mdion1/ESC_firmware/ESC schem and pcb layout - alt/ESC.kicad_pcb

## KiCad design ESC schem and pcb layout - alt/ESC.kicad_pcb (2023-04-29)

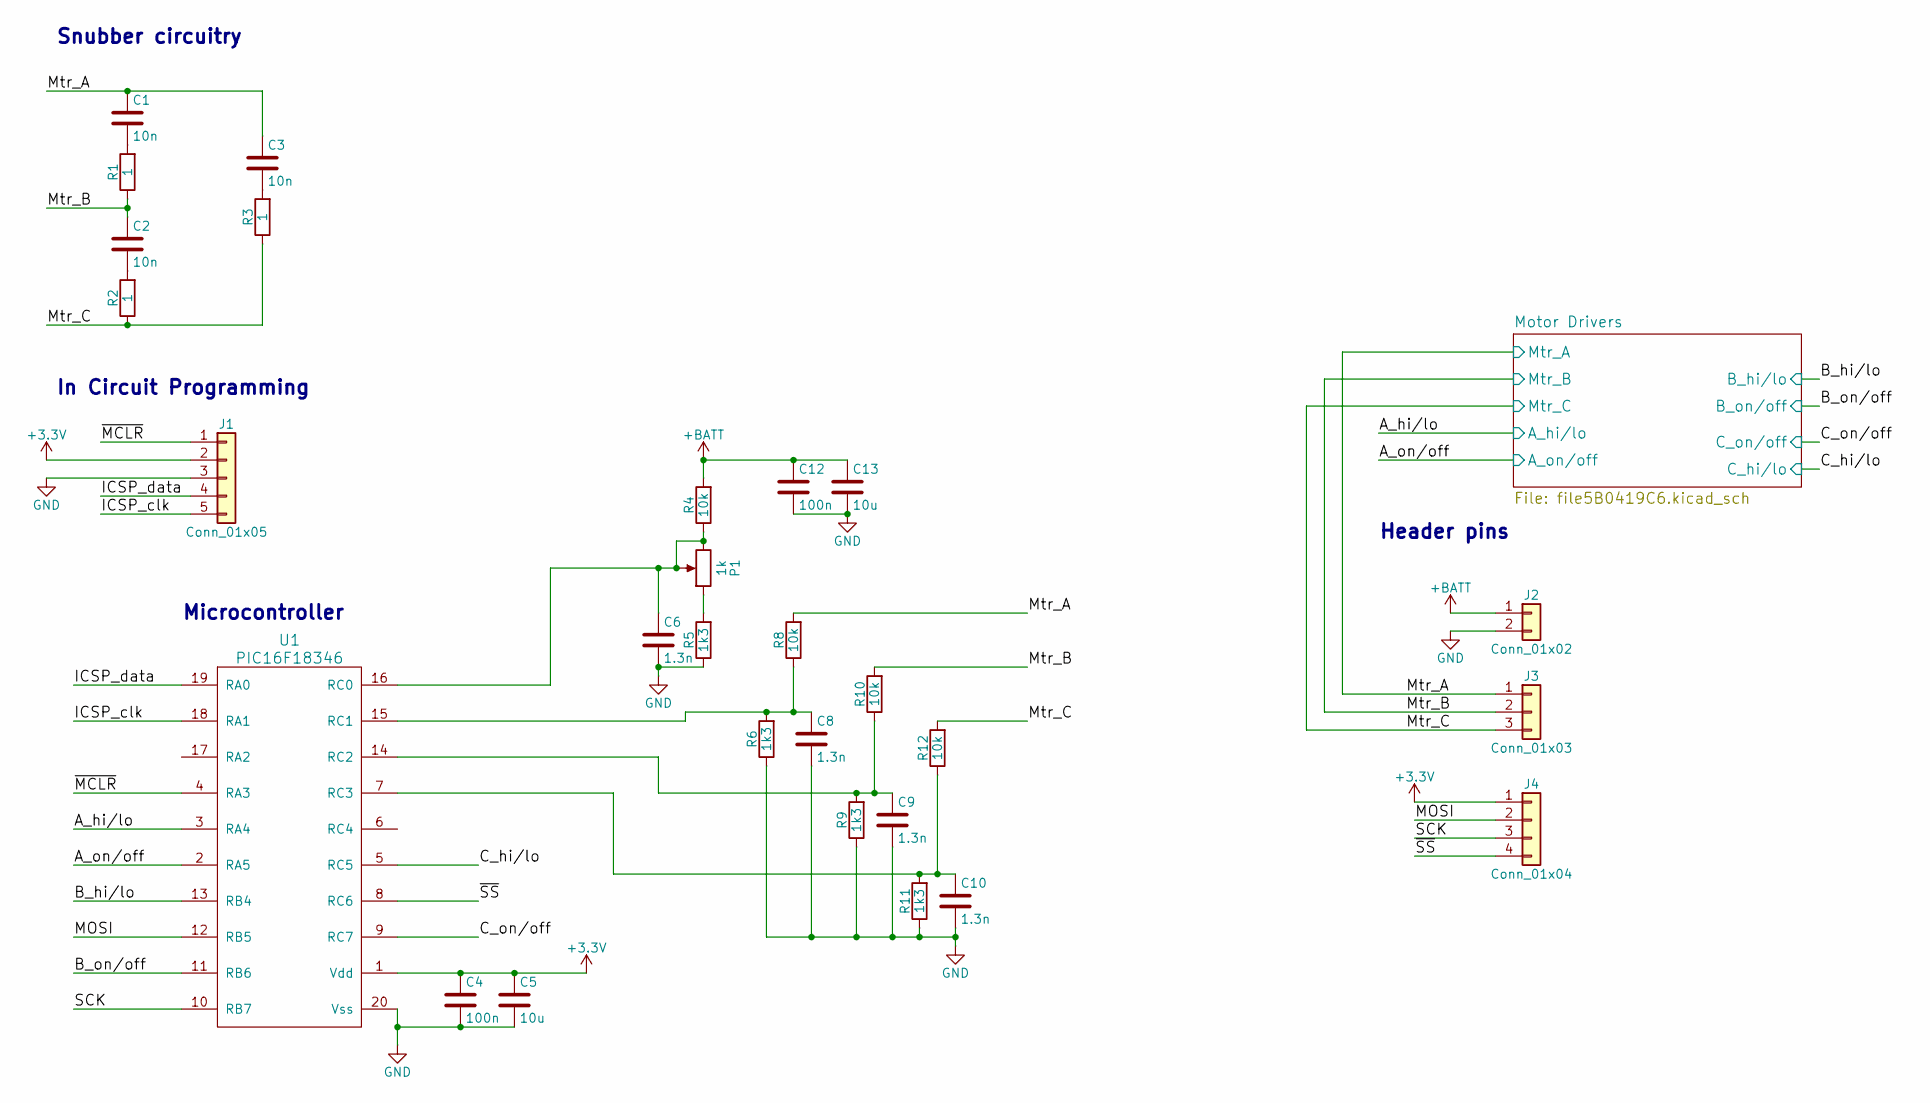
[picture p1: schematic ESC.kicad_sch]

Parts:
C1, C2, C3: 10n; C_0603_HandSoldering
C4, C12: 100n; C_0603_HandSoldering
C5, C13: 10u; C_0603_HandSoldering
C6, C8, C9, C10: 1.3n; C_0603_HandSoldering
J1: Conn_01x05; Male_header_pins_1x5
J2: Conn_01x02; Wire-to-board_1x2
J3: Conn_01x03; Wire-to-board_1x3
J4: Conn_01x04; Wire_to_board_cluster__4
P1: 1k; Potentiometer_Trimmer_Bourns_3223W
R1, R2, R3: 1; R_0603_HandSoldering
R4, R8, R10, R12: 10k; R_0603_HandSoldering
R5, R6, R9, R11: 1k3; R_0603_HandSoldering
U1: PIC16F18346; SOIC-20W_7.5x12.8mm_Pitch1.27mm

Connections:
+3V3: C4.1, C5.1, J1.2, J4.1, U1.1 (Vdd)
+BATT: C12.1, C13.1, J2.1, R4.2; also elsewhere on the board
/A_hi/lo: U1.3 (RA4); also elsewhere on the board
/A_on/off: U1.2 (RA5); also elsewhere on the board
/B_hi/lo: U1.13 (RB4); also elsewhere on the board
/B_on/off: U1.11 (RB6); also elsewhere on the board
/C_hi/lo: U1.5 (RC5); also elsewhere on the board
/C_on/off: U1.9 (RC7); also elsewhere on the board
/ICSP_clk: J1.5, U1.18 (RA1)
/ICSP_data: J1.4, U1.19 (RA0)
/MOSI: J4.2, U1.12 (RB5)
/Mtr_A: C1.1, C3.1, J3.1, R8.2; also elsewhere on the board
/Mtr_B: C2.1, J3.2, R1.1, R10.2; also elsewhere on the board
/Mtr_C: J3.3, R2.1, R3.1, R12.2; also elsewhere on the board
/SCK: J4.3, U1.10 (RB7)
/~MCLR: J1.1, U1.4 (RA3)
/~SS: J4.4, U1.8 (RC6)
GND: C4.2, C5.2, C6.2, C8.2, C9.2, C10.2, C12.2, C13.2, J1.3, J2.2, R5.1, R6.1, R9.1, R11.1, U1.20 (Vss); also elsewhere on the board
unnamed: C1.2, R1.2
unnamed: C2.2, R2.2
unnamed: C3.2, R3.2
unnamed: C6.1, P1.2, P1.3, R4.1, U1.16 (RC0)
unnamed: C8.1, R6.2, R8.1, U1.15 (RC1)
unnamed: C9.1, R9.2, R10.1, U1.14 (RC2)
unnamed: C10.1, R11.2, R12.1, U1.7 (RC3)
unnamed: P1.1, R5.2

Notes on the sheet:
In Circuit Programming
Header pins
Microcontroller
Snubber circuitry

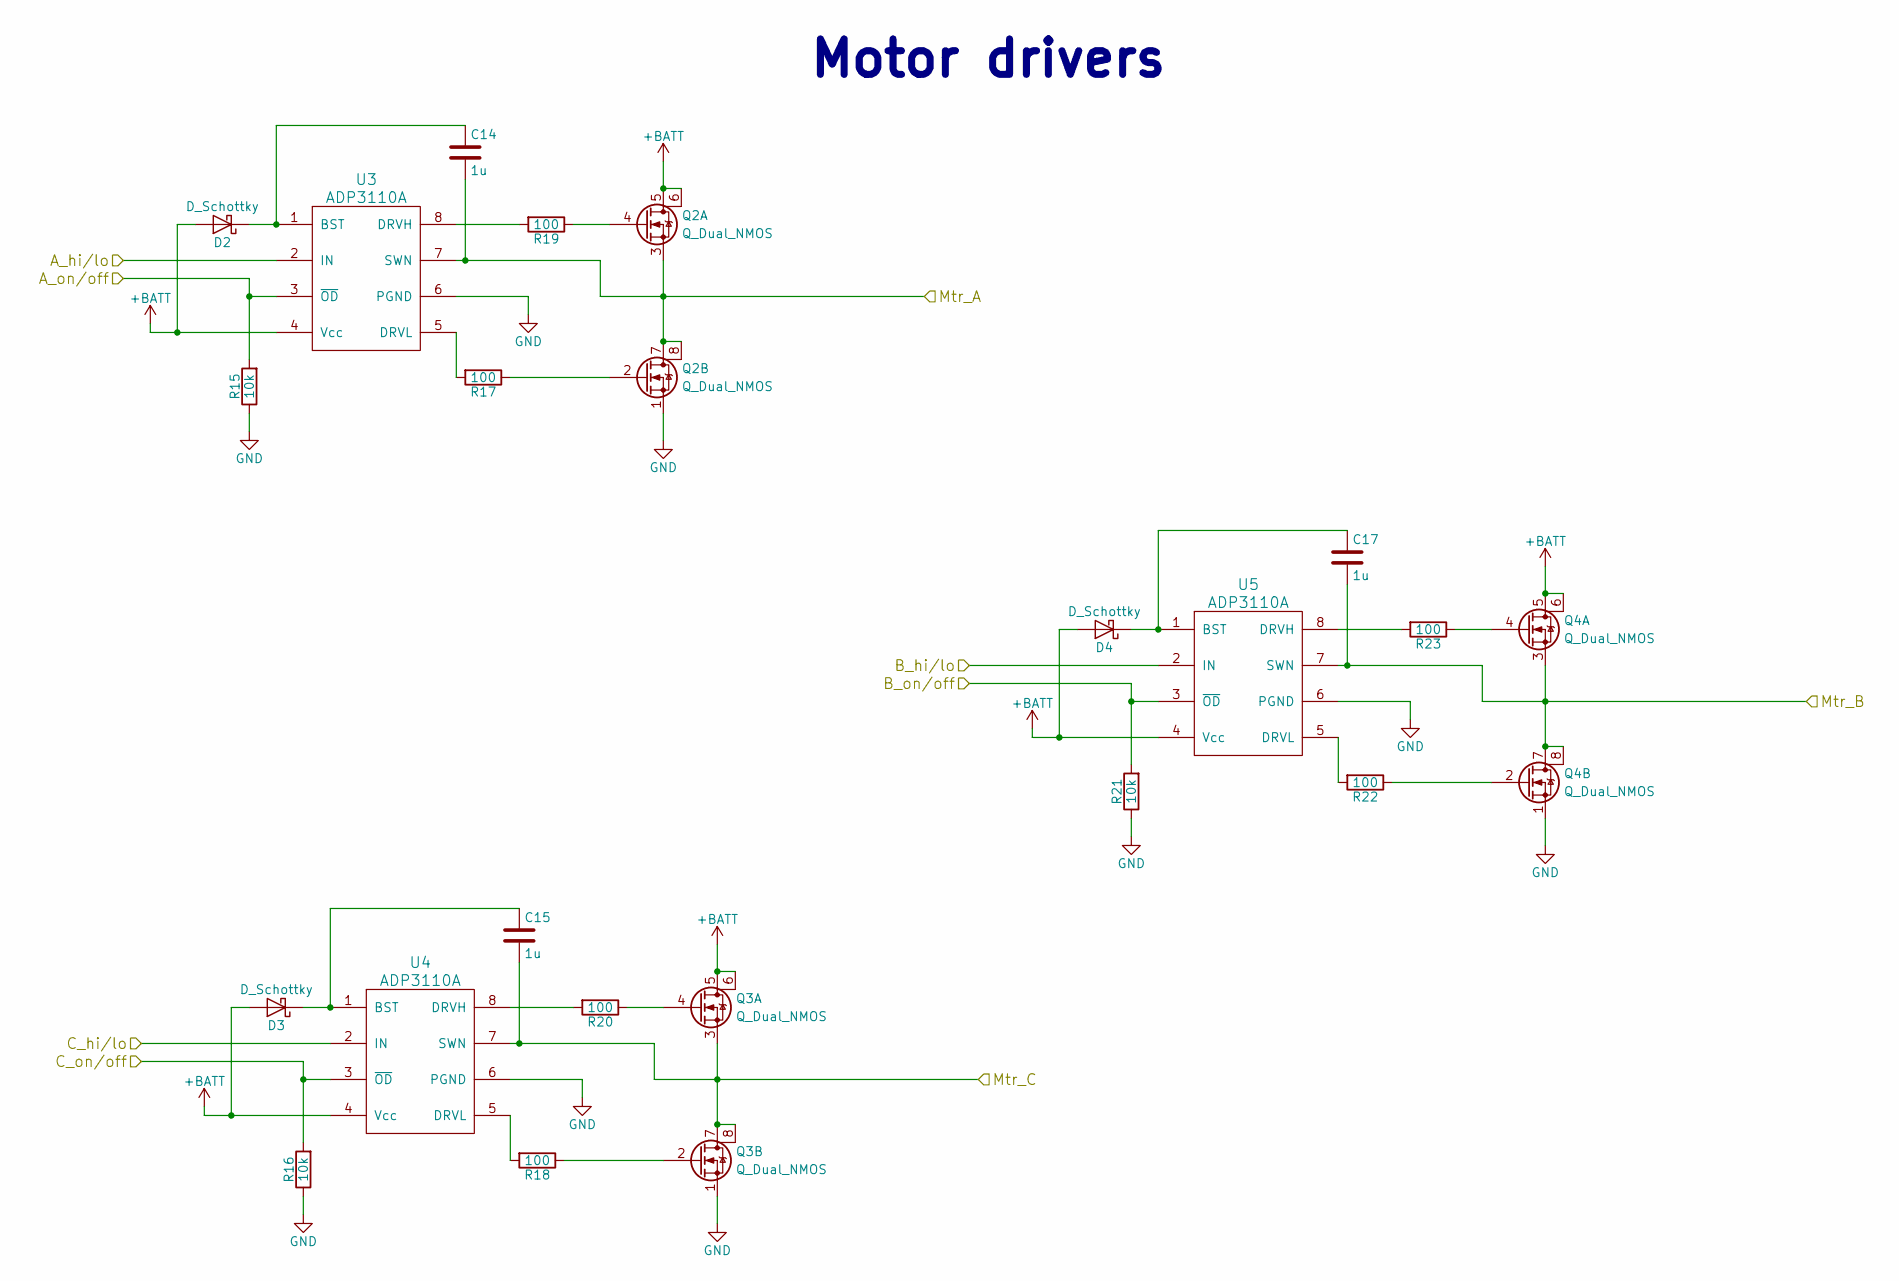
[picture p2: schematic file5B0419C6.kicad_sch]

Parts:
C14, C15, C17: 1u; C_0603_HandSoldering
D2, D3, D4: D_Schottky; D_0603
Q2, Q3, Q4: Q_Dual_NMOS; SOIC-8_3.9x4.9mm_Pitch1.27mm
R15, R16, R21: 10k; R_0603_HandSoldering
R17, R18, R19, R20, R22, R23: 100; R_0603_HandSoldering
U3, U4, U5: ADP3110A; SOIC-8_3.9x4.9mm_Pitch1.27mm

Connections:
+BATT: D2.2 (A), D3.2 (A), D4.2 (A), Q2.5 (D1), Q2.6 (D2), Q3.5 (D1), Q3.6 (D2), Q4.5 (D1), Q4.6 (D2), U3.4 (Vcc), U4.4 (Vcc), U5.4 (Vcc); also elsewhere on the board
/A_hi/lo: U3.2 (IN); also elsewhere on the board
/A_on/off: R15.2, U3.3 (~OD); also elsewhere on the board
/B_hi/lo: U5.2 (IN); also elsewhere on the board
/B_on/off: R21.2, U5.3 (~OD); also elsewhere on the board
/C_hi/lo: U4.2 (IN); also elsewhere on the board
/C_on/off: R16.2, U4.3 (~OD); also elsewhere on the board
/Mtr_A: C14.2, Q2.3 (S), Q2.7 (D1), Q2.8 (D2), U3.7 (SWN); also elsewhere on the board
/Mtr_B: C17.2, Q4.3 (S), Q4.7 (D1), Q4.8 (D2), U5.7 (SWN); also elsewhere on the board
/Mtr_C: C15.2, Q3.3 (S), Q3.7 (D1), Q3.8 (D2), U4.7 (SWN); also elsewhere on the board
GND: Q2.1 (S), Q3.1 (S), Q4.1 (S), R15.1, R16.1, R21.1, U3.6 (PGND), U4.6 (PGND), U5.6 (PGND); also elsewhere on the board
unnamed: C14.1, D2.1 (K), U3.1 (BST)
unnamed: C15.1, D3.1 (K), U4.1 (BST)
unnamed: C17.1, D4.1 (K), U5.1 (BST)
unnamed: Q2.2 (G2), R17.1
unnamed: Q2.4 (G2), R19.1
unnamed: Q3.2 (G2), R18.1
unnamed: Q3.4 (G2), R20.1
unnamed: Q4.2 (G2), R22.1
unnamed: Q4.4 (G2), R23.1
unnamed: R17.2, U3.5 (DRVL)
unnamed: R18.2, U4.5 (DRVL)
unnamed: R19.2, U3.8 (DRVH)
unnamed: R20.2, U4.8 (DRVH)
unnamed: R22.2, U5.5 (DRVL)
unnamed: R23.2, U5.8 (DRVH)

Notes on the sheet:
Motor drivers

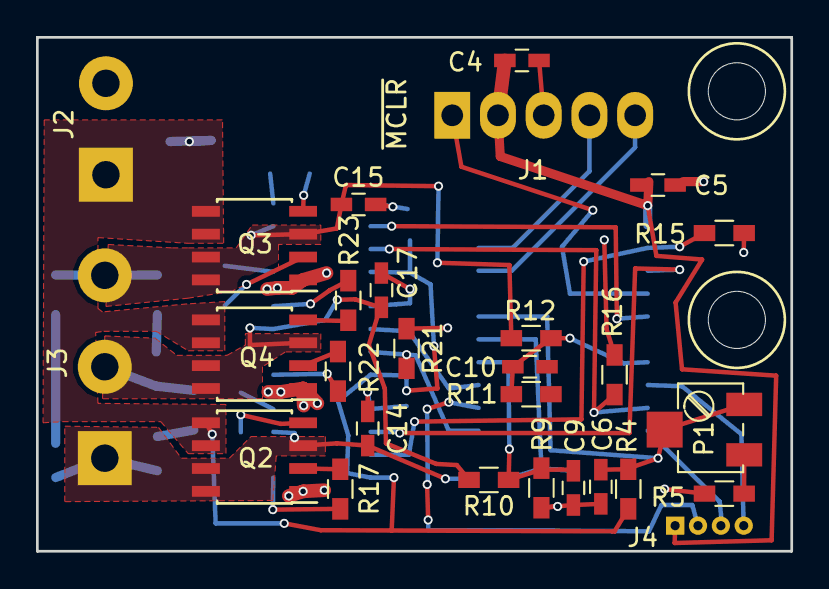
[picture p3: board ESC.kicad_pcb from above]

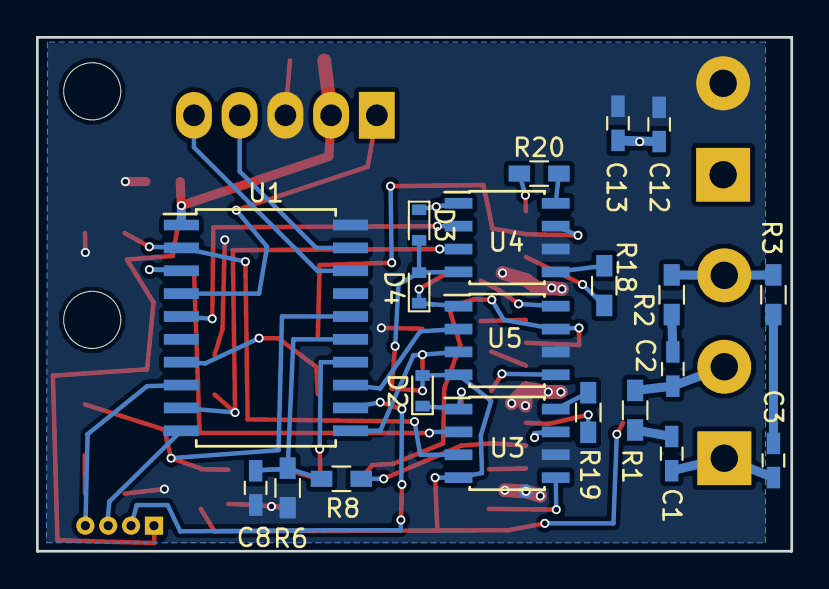
[picture p4: board ESC.kicad_pcb from below]

Board: 2 copper layers, 41.9 x 28.5 mm, 49 parts (21 on the bottom side), 41 nets.
