mdion1/ESC_firmware/src/ESC_logic.c

#include "ESC_logic.h"

motor_state_t MotorState;

int16_t OpenLoopCommutationTable[256] = 
{
   -24824	,
-23220	,
-21810	,
-20562	,
-19449	,
-18450	,
-17549	,
-16732	,
-15988	,
-15306	,
-14681	,
-14105	,
-13572	,
-13078	,
-12619	,
-12190	,
-11790	,
-11416	,
-11064	,
-10734	,
-10422	,
-10129	,
-9851	,
-9588	,
-9339	,
-9102	,
-8877	,
-8663	,
-8459	,
-8265	,
-8079	,
-7901	,
-7731	,
-7568	,
-7412	,
-7262	,
-7119	,
-6980	,
-6847	,
-6719	,
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
};

void initMotorState()
{
    MotorState.phase = 0;
    MotorState.status = STANDBY;
    uint8_t i = 0;
    for (; i < COMMUTATION_FILTER_SIZE; i++)
    {
        MotorState.closedLoopCtrl.rollingCommutationFilter[i] = OpenLoopCommutationTable[255];
    }
}

void MotorStateTasks()
{
    switch(MotorState.status)
    {
        case STANDBY:
            if (MotorState.closedLoopCtrl.dutyCycle != 0)
            {
                MotorState.status = STARTUP;
                MotorState.openLoopCtrl.tableIndex = 0;
                MotorState.commutationTimerVal = OpenLoopCommutationTable[0];
                reset_commutation_timer(MotorState.commutationTimerVal);
                start_commutation_timer(true);
            }
            break;
        case STARTUP:
        {
            /* ramp up openLoopCtrl.tableIndex from 0 to 255, incrementing every 50ms*/
            if (check_event_timer_overflow())
            {
                static uint8_t accelerationCounter = 0;
                if (++accelerationCounter == 5)
                {
                    accelerationCounter = 0;
                    MotorState.commutationTimerVal = OpenLoopCommutationTable[++MotorState.openLoopCtrl.tableIndex];
                    if (MotorState.openLoopCtrl.tableIndex == 255)
                    {
                        MotorState.status = CLOSED_LOOP_CTRL;
                        RC4PPS = 0b10111;//debugging only; cmp output pin only turns on during closed loop ctrl
                        enable_cmp_interrupt(true);
                    }
                }
            }
        }
            break;
        case STALL:
            break;
        case OPEN_LOOP_CTRL:
            break;
        case CLOSED_LOOP_CTRL:
        {
            if (MotorState.closedLoopCtrl.newComparatorCaptureDataFlag)
            {
                MotorState.closedLoopCtrl.newComparatorCaptureDataFlag = 0;
                recalculate_commutation_time();
            }
        }
            break;
    }
}

void recalculate_commutation_time()
{
    static int32_t filterSum = COMMUTATION_FILTER_SIZE * (-1333);
    uint8_t i = MotorState.closedLoopCtrl.filterIndex;
    int16_t x = (MotorState.commutationTimerVal - MotorState.closedLoopCtrl.newComparatorCaptureData) * 2;
    filterSum += x - MotorState.closedLoopCtrl.rollingCommutationFilter[i];
    MotorState.closedLoopCtrl.rollingCommutationFilter[i] = x;
    //MotorState.commutationTimerVal = filterSum / COMMUTATION_FILTER_SIZE;
    MotorState.commutationTimerVal = -1333;
    
//    /*debugging only */ 
//    if (MotorState.commutationTimerVal < -1350)
//    {
//        MotorState.commutationTimerVal = -1350;
//    }
//    if (MotorState.commutationTimerVal > -1310)
//    {
//        MotorState.commutationTimerVal = -1310;
//    }
    MotorState.closedLoopCtrl.filterIndex++;
    MotorState.closedLoopCtrl.filterIndex %= COMMUTATION_FILTER_SIZE;
}

#ifndef CCW_OPERATION

void commutate()
{
    switch (MotorState.phase)
    {
        /* Phase 0: Power phases A/C, B floats */
        case 0:
        {
            enable_cmp_interrupt(false);
            PHASE_A_HIGH();
            PHASE_C_LOW();
            PHASE_B_TRIS();
            PWM_ASSIGN_PHASE_A();
            MotorState.phase = 1;
        }
        break;
        /* Phase 1: Power phases B/C, A floats; comparator on */
        case 1:
        {
            PHASE_B_HIGH();
            PHASE_C_LOW();
            PHASE_A_TRIS();
            PWM_ASSIGN_PHASE_B();
            ACMP_ASSIGN_PHASE_A();
            enable_cmp_interrupt(true);
            MotorState.phase = 2;
        }
        break;
        /* Phase 2: Power phases B/A, C floats */
        case 2:
        {
            enable_cmp_interrupt(false);
            PHASE_B_HIGH();
            PHASE_A_LOW();
            PHASE_C_TRIS();
            PWM_ASSIGN_PHASE_B();
            MotorState.phase = 3;
        }
        break;
        /* Phase 3: Power phases C/A, B floats; comparator on */
        case 3:
        {
            PHASE_C_HIGH();
            PHASE_A_LOW();
            PHASE_B_TRIS();
            PWM_ASSIGN_PHASE_C();
            ACMP_ASSIGN_PHASE_B();
            enable_cmp_interrupt(true);
            MotorState.phase = 4;
        }
        break;
        /* Phase 4: Power phases C/B, A floats */
        case 4:
        {
            enable_cmp_interrupt(false);
            PHASE_C_HIGH();
            PHASE_B_LOW();
            PHASE_A_TRIS();
            PWM_ASSIGN_PHASE_C();
            MotorState.phase = 5;
        }
        break;
        /* Phase 5: Power phases A/B, C floats; comparator on */
        case 5:
        {
            PHASE_A_HIGH();
            PHASE_B_LOW();
            PHASE_C_TRIS();
            PWM_ASSIGN_PHASE_A();
            ACMP_ASSIGN_PHASE_C();
            enable_cmp_interrupt(true);
            MotorState.phase = 0;
        }
        break;
        default:
        break;
    }
}

#else

void commutate()
{
    switch (MotorState.phase)
    {
        /* Phase 0: Power phases A/C, B floats; comparator on */
        case 0:
        {
            PHASE_A_HIGH();
            PHASE_C_LOW();
            PHASE_B_TRIS();
            PWM_ASSIGN_PHASE_A();
            ACMP_ASSIGN_PHASE_B();
            if (MotorState.status == CLOSED_LOOP_CTRL)
            {
                blank(100);
                enable_cmp_interrupt(true);
            }
            MotorState.phase = 5;
        }
        break;
        /* Phase 1: Power phases B/C, A floats */
        case 1:
        {
            enable_cmp_interrupt(false);
            PHASE_B_HIGH();
            PHASE_C_LOW();
            PHASE_A_TRIS();
            PWM_ASSIGN_PHASE_B();
            MotorState.phase = 0;
        }
        break;
        /* Phase 2: Power phases B/A, C floats; comparator on */
        case 2:
        {
            PHASE_B_HIGH();
            PHASE_A_LOW();
            PHASE_C_TRIS();
            PWM_ASSIGN_PHASE_B();
            ACMP_ASSIGN_PHASE_C();
            if (MotorState.status == CLOSED_LOOP_CTRL)
            {
                blank(100);
                enable_cmp_interrupt(true);
            }
            MotorState.phase = 1;
        }
        break;
        /* Phase 3: Power phases C/A, B floats */
        case 3:
        {
            enable_cmp_interrupt(false);
            PHASE_C_HIGH();
            PHASE_A_LOW();
            PHASE_B_TRIS();
            PWM_ASSIGN_PHASE_C();
            MotorState.phase = 2;
        }
        break;
        /* Phase 4: Power phases C/B, A floats; comparator on */
        case 4:
        {
            PHASE_C_HIGH();
            PHASE_B_LOW();
            PHASE_A_TRIS();
            PWM_ASSIGN_PHASE_C();
            ACMP_ASSIGN_PHASE_A();
            if (MotorState.status == CLOSED_LOOP_CTRL)
            {
                blank(100);
                enable_cmp_interrupt(true);
            }
            MotorState.phase = 3;
        }
        break;
        /* Phase 5: Power phases A/B, C floats */
        case 5:
        {
            enable_cmp_interrupt(false);
            PHASE_A_HIGH();
            PHASE_B_LOW();
            PHASE_C_TRIS();
            PWM_ASSIGN_PHASE_A();
            MotorState.phase = 4;
        }
        break;
        default:
        break;
    }
}

#endif //#ifndef CCW_OPERATION
