mdion1/ESC_firmware/src/teensy_ESC_test_firmware/config.h

//#ifndef _CONFIG_H
//#define _CONFIG_H
//
//// PIC16F18346 Configuration Bit Settings
//
//// 'C' source line config statements
//
//// CONFIG1
//#pragma config FEXTOSC = OFF    // FEXTOSC External Oscillator mode Selection bits (Oscillator not enabled)
//#pragma config RSTOSC = HFINT32 // Power-up default value for COSC bits (HFINTOSC with 2x PLL (32MHz))
//#pragma config CLKOUTEN = OFF   // Clock Out Enable bit (CLKOUT function is disabled; I/O or oscillator function on OSC2)
//#pragma config CSWEN = OFF      // Clock Switch Enable bit (The NOSC and NDIV bits cannot be changed by user software)
//#pragma config FCMEN = OFF      // Fail-Safe Clock Monitor Enable (Fail-Safe Clock Monitor is disabled)
//
//// CONFIG2
//#pragma config MCLRE = ON       // Master Clear Enable bit (MCLR/VPP pin function is MCLR; Weak pull-up enabled)
//#pragma config PWRTE = OFF      // Power-up Timer Enable bit (PWRT disabled)
//#pragma config WDTE = OFF       // Watchdog Timer Enable bits (WDT disabled; SWDTEN is ignored)
//#pragma config LPBOREN = OFF    // Low-power BOR enable bit (ULPBOR disabled)
//#pragma config BOREN = ON       // Brown-out Reset Enable bits (Brown-out Reset enabled, SBOREN bit ignored)
//#pragma config BORV = HIGH      // Brown-out Reset Voltage selection bit (Brown-out voltage (Vbor) set to 2.7V)
//#pragma config PPS1WAY = ON     // PPSLOCK bit One-Way Set Enable bit (The PPSLOCK bit can be cleared and set only once; PPS registers remain locked after one clear/set cycle)
//#pragma config STVREN = ON      // Stack Overflow/Underflow Reset Enable bit (Stack Overflow or Underflow will cause a Reset)
//#pragma config DEBUG = OFF      // Debugger enable bit (Background debugger disabled)
//
//// CONFIG3
//#pragma config WRT = OFF        // User NVM self-write protection bits (Write protection off)
//#pragma config LVP = ON         // Low Voltage Programming Enable bit (Low Voltage programming enabled. MCLR/VPP pin function is MCLR. MCLRE configuration bit is ignored.)
//
//// CONFIG4
//#pragma config CP = OFF         // User NVM Program Memory Code Protection bit (User NVM code protection disabled)
//#pragma config CPD = OFF        // Data NVM Memory Code Protection bit (Data NVM code protection disabled)
//
//// #pragma config statements should precede project file includes.
//// Use project enums instead of #define for ON and OFF.
//
//#include <xc.h>
//
//#endif
