mdion1/ESC_firmware/(commit log)

2018-06-14 Simple open-loop control, fixed PWM, directly-controlled commutation period
    [BAREMETAL_pins.c, ESC_logic.c, ESC_logic.h, main.c]
2018-07-10 Fixed some bugs, but comparator still triggers early
    [BAREMETAL_pins.c, BAREMETAL_pins.h, ESC_logic.c, ESC_logic.h]
2018-07-10 Added comparator output pin for easier debugging of comparator triggering
2019-09-04 Initial commit, added Arduino project to run motor using Teensy 3.2
2019-09-05 comparator and PWM power up and work
2019-09-06 Untested code, links CMP rising edge to timer input capture; adds interrupts for commutation timer and comparator
2019-09-08 Syntax errors, minor changes before testing: DMA only initialized with USE_DMA_CHANNEL define; DMAMUX trigger source was incorrect; set up test for commutation timer overflow
    [BAREMETAL_pins.c, BAREMETAL_pins.h, ESC_logic.h, interrupts.cpp, teensy_ESC_test_firmware.ino]
2019-09-11 Open loop mode works; bug--commutation timer prescaler is off by factor of 2
    [BAREMETAL_pins.cpp, BAREMETAL_pins.h, ESC_logic.c, ESC_logic.cpp, ESC_logic.h, interrupts.cpp, teensy_ESC_test_firmware.ino]
2019-09-22 Bug: motor commutation order was wrong, cmp phase was out of order (it's only fixed for CCW mode); control loop works up to ~2500rpm
    [BAREMETAL_pins.c, BAREMETAL_pins.cpp, BAREMETAL_pins.h, ESC_logic.c, ESC_logic.cpp, ESC_logic.h, interrupts.cpp]
2019-09-22 Added in a filtered derivative tracker to help damped oscillation
    [ESC_logic.cpp, filter.cpp, filter.h, interrupts.cpp, teensy_ESC_test_firmware.ino]
2019-09-29 Caught a couple bugs, one in recalculate_commutation_time() and one in the timer interrupt; added debugging_buf class
    [ESC_logic.cpp, debugging_buf.cpp, debugging_buf.h, interrupts.cpp, teensy_ESC_test_firmware.ino]
2019-09-29 Tweaked deriv filter size and limits, implemented negative deriv control
2023-04-29 Added old revisions + rev2 (WIP)
    [ESC BOM.xlsx, ESC-2023-04-02-11-14-59.sch, ESC-2023-04-02-14-59-23.sch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]
